guti10x/Data-Acquisition-Dashware-FUEM/Nextion - NX4827P043/README.md

# Versiones de la interfaz

## Dashboard_V1 
- Con indicadores de temperatura de los frenos del vehículo
- Con barra de progreso como indicadores de revoluciones
- Sin testigos SDC, IGN, CAN, STR, FAL y FAR
- Con loading page de carga

dash_V1

## Dashboard_V2
- Sin indicadores de temperatura de los frenos del vehículo
- Con barra de progreso como indicadores de revoluciones
- Sin testigos SDC, IGN, CAN, STR, FAL y FAR
- Con loading page de carga

dash_V2

## Dashboard_V3
- Sin indicadores de temperatura de los frenos del vehículo
- Con rectángulos de texto como indicadores de revoluciones (más óptimo)
- Sin testigos SDC, IGN, CAN, STR, FAL y FAR
- Con loading page de carga

dash_V3

## Dashboard_V4
- Sin indicadores de temperatura de los frenos del vehículo
- Con rectángulos de texto como indicadores de revoluciones (más óptimo)
- Con testigos SDC, IGN, CAN, STR, FAL y FAR versión 1
- Con loading page de carga
  
dash_V5

## Dashboard_V5
- Sin indicadores de temperatura de los frenos del vehículo
- Con rectángulos de texto como indicadores de revoluciones (más óptimo)
- Con testigos SDC, IGN, CAN, STR, FAL y FAR versión 1
- Sin loading page de carga

dash_V5

## Dashboard_V6
- Sin indicadores de temperatura de los frenos del vehículo
- Con rectángulos de texto como indicadores de revoluciones (más óptimo)
- Con testigos SDC, IGN, CAN, STR, FAL y FAR versión 2
- Sin loading pagede carga

dash_v6

<br><br>
# Pasos para cargar la Interfaz en la Pantalla Nextion

## Requisitos
- Tener instalado el Nextion Editor.

## Pasos a Seguir
1. **Abrir Nextion Editor:**
   - Iniciar/Descargar Nextion Editor.

2. **Cargar la Interfaz:**
   - Cargar la versión deseada de la interfaz en Nextion Editor.

3. **Generar Archivo TFT:**
   - Generar el archivo .TFT de la interfaz como se  uestra en la imagen:

        Captura dsse pantalla 2024-07-30 134819

5. **Guardar en Tarjeta SD:**
   - Guardar el archivo .TFT en una tarjeta SD asegurándote de que sea el único archivo en la tarjeta.

6. **Cargar la Interfaz en la Pantalla Nextion:**
   - Insertar la tarjeta SD en la pantalla Nextion.
   - Cargar la interfaz desde la tarjeta SD.

    Captura dsse swkdwkdmwkdmwd2024-07-30 134819

7. **Finalizar el Proceso:**
   - Retirar la tarjeta SD de la pantalla Nextion.
   - Reiniciar la pantalla y la  interfaz debería estar cargada y lista para usarse.
