guti10x/Data-Acquisition-Dashware-FUEM/Arduino - Arduino UNO/README.md

# Contenido de la carpeta:

#### `ScreenUpdater`: código utilizado en el código del firmware de la placa Arduino para actualizar e interactuar con la pantalla Nextion.
