guti10x/Data-Acquisition-Dashware-FUEM/Nexus - stm32f103r8t6/Librerias/nextion_comunication_lib_f1/README.md

# Librería para la comunicación entre la placa stm32 y la pantalla Nextion

Esta librería permite la comunicación entre la placa stm32 y la pantalla Nextion para la actualización de la interfaz de la pantalla del dashboard. La librería permite controlar y actualizar diversos parámetros y componentes visuales de la interfaz de manera eficiente. Las principales funcionalidades incluyen:

- **Actualización de valores en la interfaz**: La librería proporciona funciones para actualizar en tiempo real la velocidad, el voltaje de la batería, la temperatura del motor, las revoluciones, la marcha, los frenos y las barras de freno y aceleración.

- **Actualización de colores de componentes**: Permite cambiar el color de fondo de componentes individuales o de todos los componentes del dashboard para facilitar la visualización de alertas o estados específicos.

- **Cambio de interfaz**: Soporta la transición entre diferentes vistas de la pantalla, como cambiar de la vista de carga a la interfaz principal con los indicadores.

Estas funcionalidades están diseñadas para proporcionar una interfaz de usuario dinámica y reactiva, mejorando la experiencia de conducción y monitoreo en un coche de Formula Student.

## Instalación
Consulta cómo instalar e implementar la biblioteca en cualquier proyecto en STMCUBE IDE en el [manual de instalación de nextion_comunication_lib](./docs/Manual%20de%20instalación%20nextion_comunication_lib.pdf).

## Documentación
Consulta la [documentación de nextion_comunication_lib](./docs/Documentación%20nextion_comunication_lib.pdf) para obtener más información sobre cómo utilizar la librería y sus características.
