guti10x/Data-Acquisition-Dashware-FUEM/Nexus - stm32f103r8t6/Documentación de la placa/Documentación placa Nexus.pdf

# Formula UEM NEXUS

Designed by Daniel Romero de avila 2024

## Contents

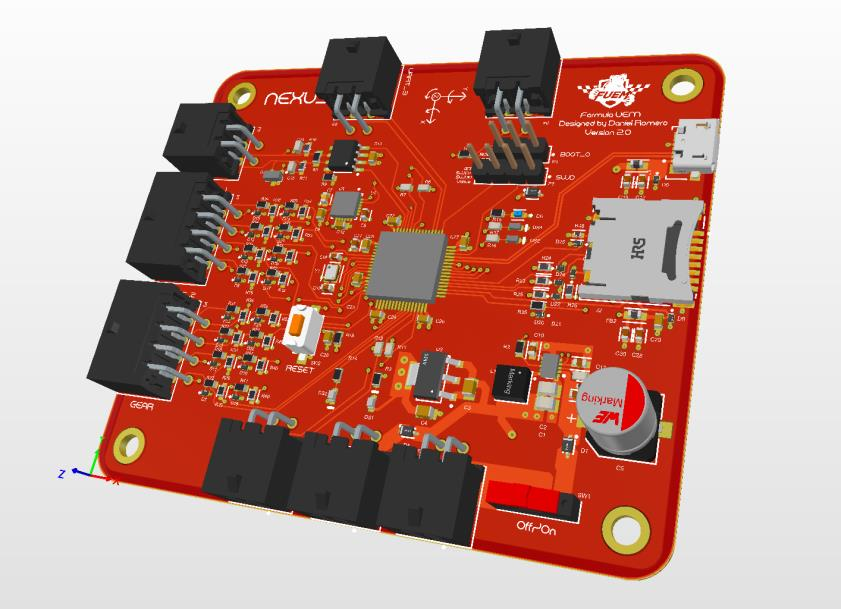
[picture p1: figure]

## 1. Overview

- 12V and 5V Power Supply
- STM32F103R8T6 Microcontroller
- Data Acquisition by SD Card
- Dashboard Power Supply
- IMU and Gyroscope 6 Axis MPU-6050
- 16 ADC 12 bit resolution
- I2C
- 2x UART
- USB

## 2. Pinout

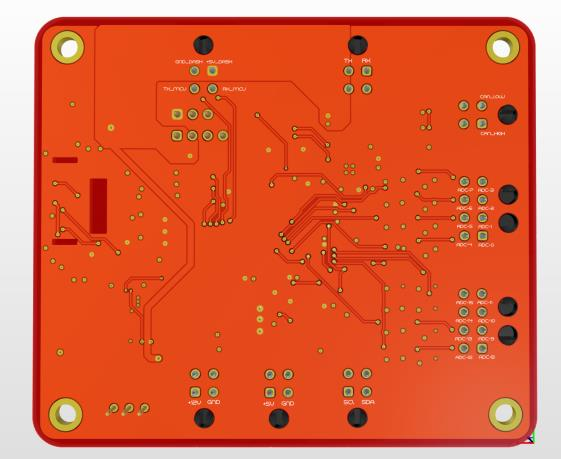
[picture p2: figure]
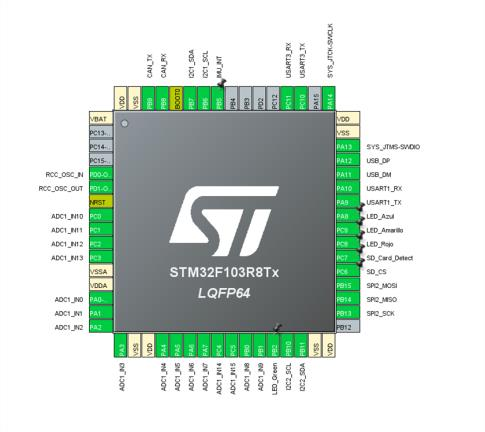
[picture p3: figure]

## 3. Technical Specification

| Unit | Value
Power voltage | V | 13.8 & 5V
Maximum current | A | 0.5
Dimensions | mm*mm | 83.27 * 71.39
Weigh | g
Temperature range | C | -20 to 50
Wire diameter Voltage range ADCs | AWG
| V | 22 to 30
| | 0 to 3.3

## 4. Assembly drawings

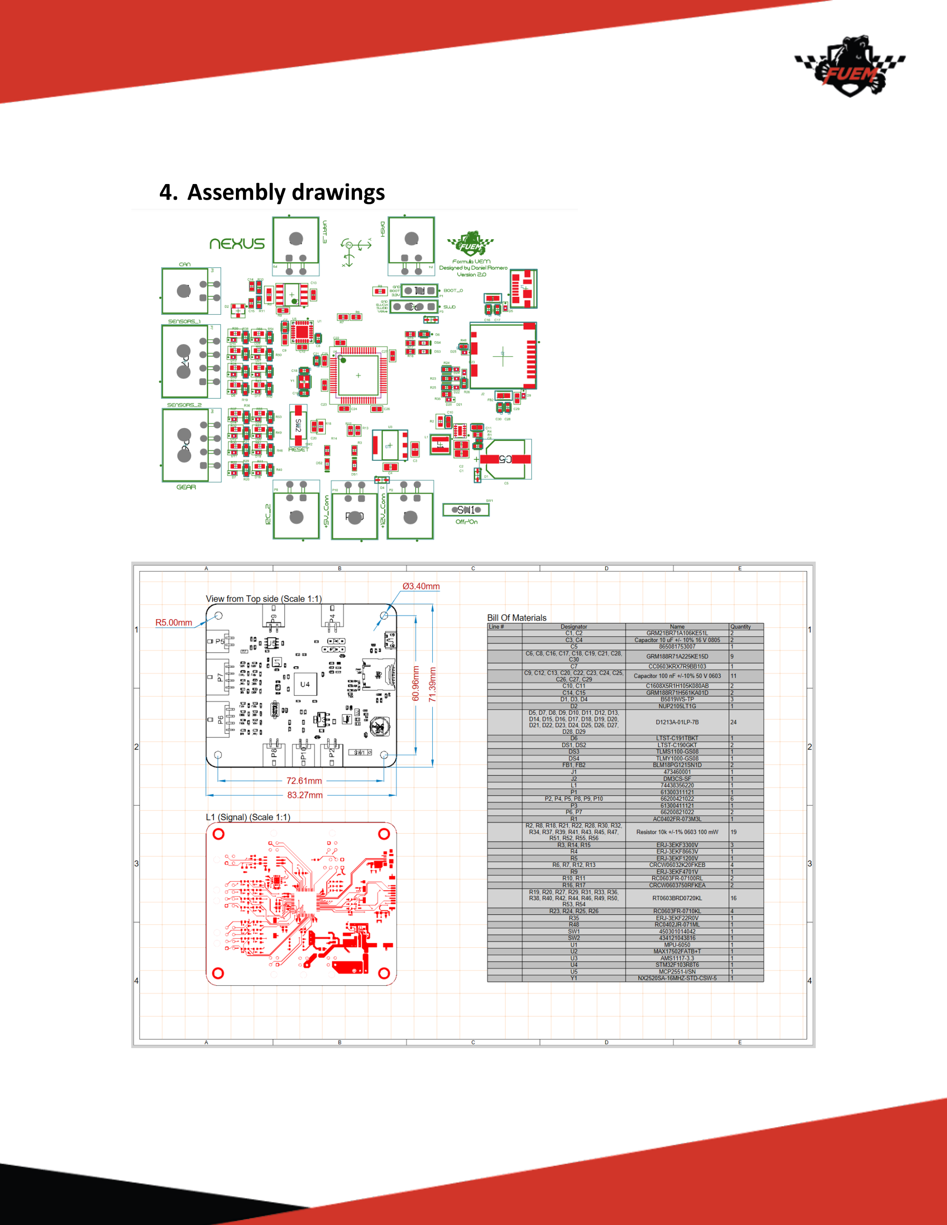
[picture p4: page 3]

## 6. Schematic

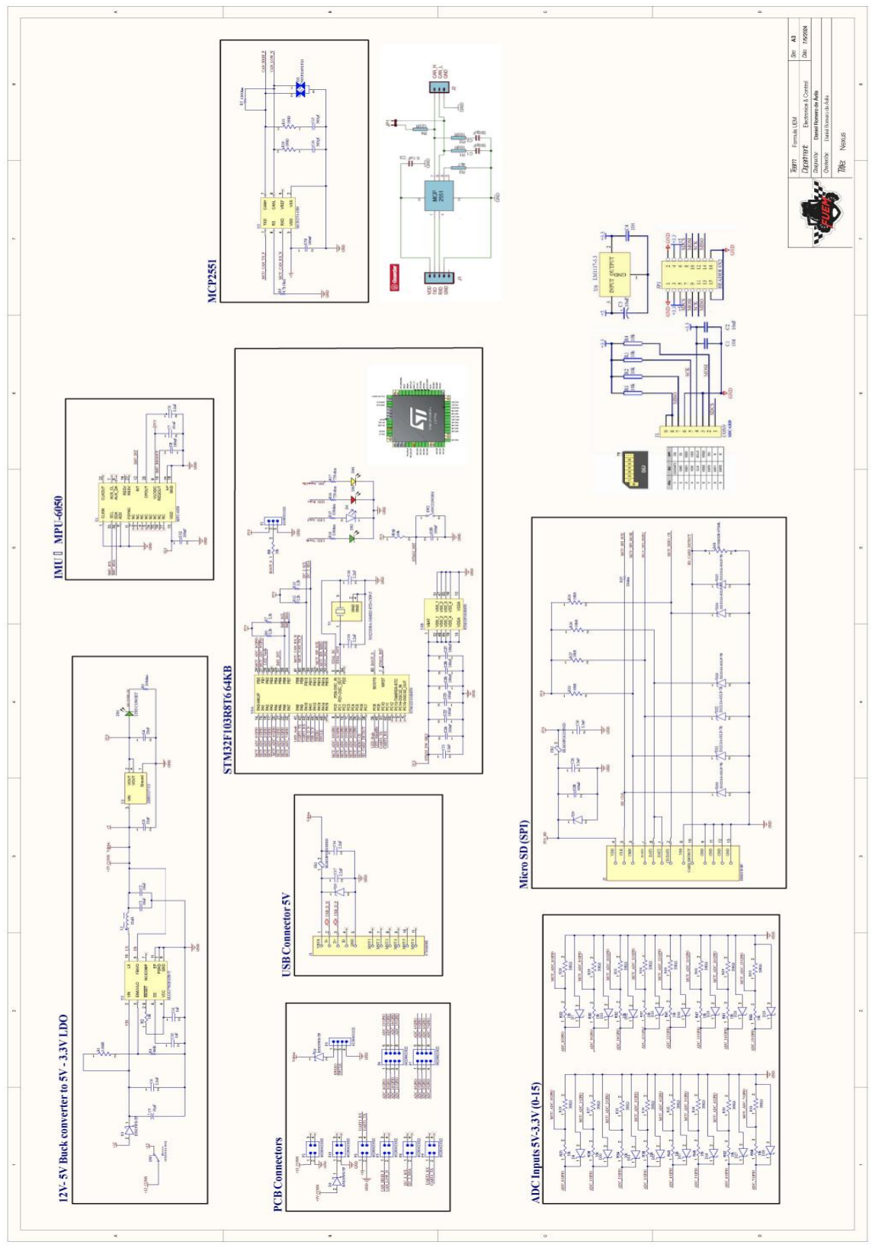
[picture p5: figure]

## 7. Bill of material

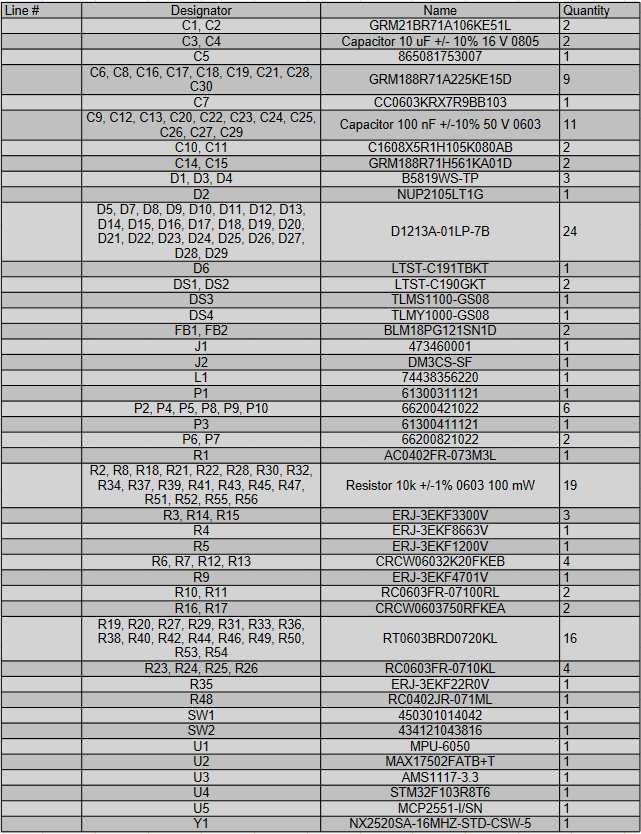
[picture p6: figure]

## 8. Conclusions

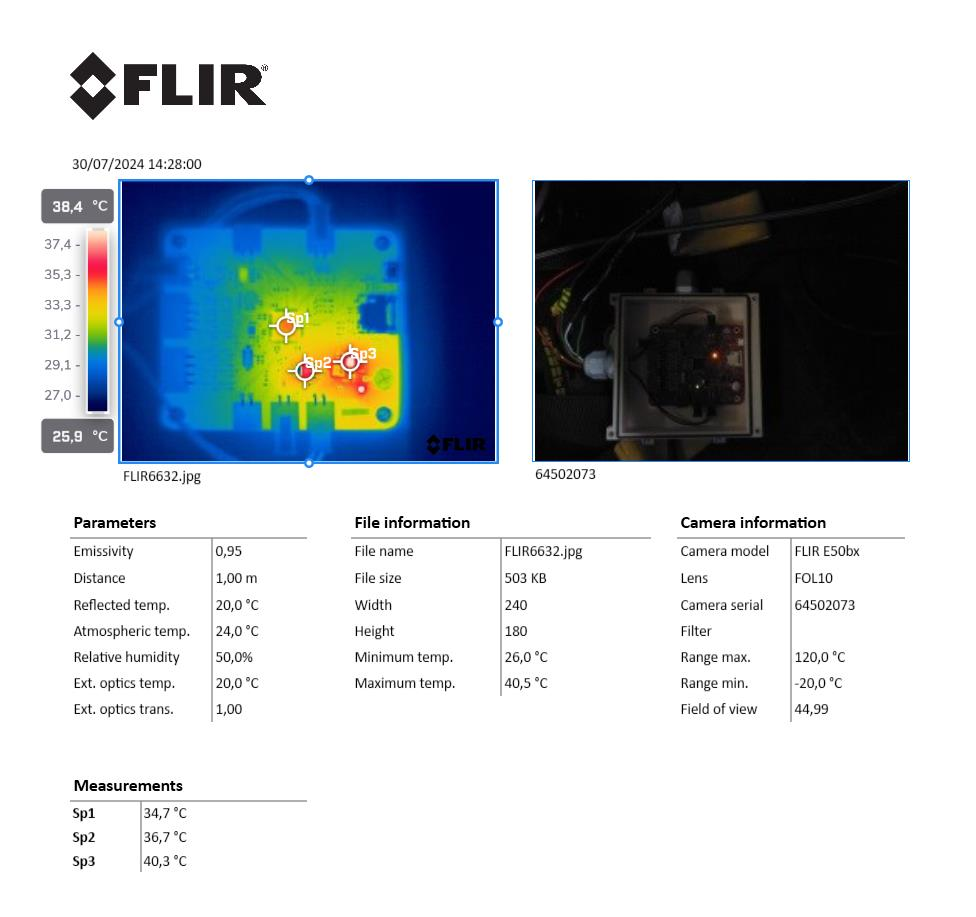
[picture p7: figure]
