guti10x/Data-Acquisition-Dashware-FUEM/Nexus - stm32f103r8t6/README.md

# Contenido de la carpeta:

#### `Documentación de la placa`: documentación de la electrónica de la placa Nexus 

#### `Librerías`: Librerías utilizadas en el código del firmware de la placa.

#### `Nexus Firmware V5`: Proyecto con el código del Firmware de la placa Nexus
