guti10x/Data-Acquisition-Dashware-FUEM/NucleoF4 - nucleo-f411re/README.md

# Contenido de la carpeta:

#### `nextion_comunication_lib_f4`: Librería utilizada en el código del firmware de la placa para actualizar e interactuar con la pantalla Nextion.

#### `dash_updater`: Proyecto con el código del Firmware de la placa NucleoF4
