guti10x/Data-Acquisition-Dashware-FUEM/Nextion - NX4827P043/assets interfaz/dash_back_3.png

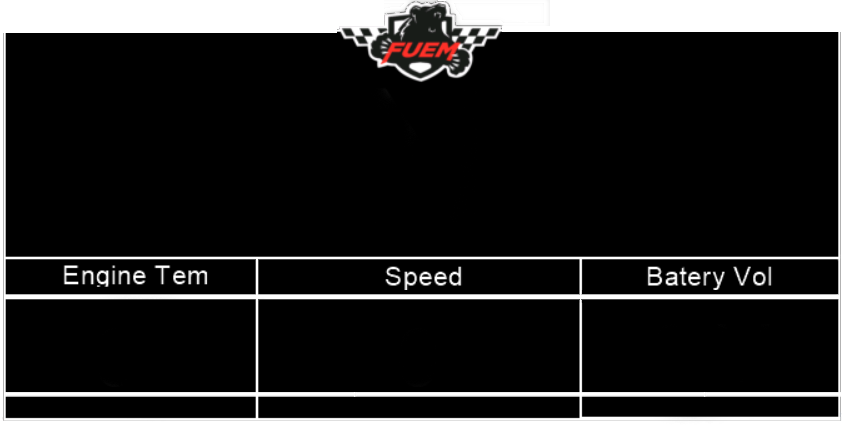
Nextion - NX4827P043/assets interfaz/dash_back_3.png
