guti10x/Data-Acquisition-Dashware-FUEM/Nexus - stm32f103r8t6/Nexus Firmware V5/Core/Src/main.c

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
/* Includes ------------------------------------------------------------------*/
#include "main.h"
#include "fatfs.h"

/* USER CODE BEGIN Includes */

#include "stdio.h"
#include "math.h"
#include "stdlib.h"
#include "stdint.h"
#include "time.h"
#include "string.h"
#include "stdbool.h"

#include "MPU_6050.h"
#include "nextion_comunication.h"
/* USER CODE END Includes */

/* USER CODE BEGIN PTD */
char Time[30];
char Date[30];
/* USER CODE END PTD */

/* USER CODE BEGIN PD */
RTC_TimeTypeDef sTime;
RTC_DateTypeDef sDate;
FATFS fs;
FIL fil;
/* USER CODE END PD */

ADC_HandleTypeDef hadc1;

CAN_HandleTypeDef hcan;

I2C_HandleTypeDef hi2c1;

RTC_HandleTypeDef hrtc;

SPI_HandleTypeDef hspi2;

UART_HandleTypeDef huart1;

void SystemClock_Config(void);
static void MX_GPIO_Init(void);
static void MX_CAN_Init(void);
static void MX_USART1_UART_Init(void);
static void MX_RTC_Init(void);
static void MX_SPI2_Init(void);
static void MX_I2C1_Init(void);
static void MX_ADC1_Init(void);
/* USER CODE BEGIN 0 */
CAN_TxHeaderTypeDef TxHeader;
CAN_RxHeaderTypeDef RxHeader;

uint32_t TxMailbox; 	//Un MAILBOX es una paquete con espacio para 4 Bytes donde se preparan los datos a enviar
						//Supports 3 different Mailboxes (Search it in the datasheet form MCU)
uint8_t TxData[8];
uint8_t RxData[8];

int Engine_Speed = 0;
uint8_t Throttle_Pos = 0;
uint8_t Coolant_Temp = 0;
uint8_t Battery_Voltage = 0;
float Battery_Voltage_Float = 0;
uint8_t Throttle_Pedal = 0;
int16_t Brake_Pressure = 0;
int16_t RPM = 0;
uint8_t Ignition = 0;
uint8_t SDC = 0;
uint8_t Sw_Starter = 0;
uint8_t Left_Fan = 0;
uint8_t Right_Fan = 0;
uint16_t Gear = 0;
uint8_t Brake_Percentage = 0;

uint8_t CAN_Status = 0;

//float Acc_X = 0;
//float Acc_Y = 0;
//float Acc_Z = 0;

uint8_t MPU_6050_Temp = 0;

// Textos para mostrar datos (se necesitan las siguintes varibles en formato texto para poder mostrarslas en la interfaz)
char RPM_text[20];  // Texto con valor de RPM
char Speed_Text[20];  // Texto con valor velocidad
char Coolant_Text[20];  // Texto con valor de temperatura del refrigerante
char Battery_Text[20];  // Texto con valor de voltaje de la batería
char Ambient_Temperature_Text[20];
char Gear_Text[5] = "N";


const char *array_elementos[] = {"speed", "revValue", "gear", "brake1", "brake2", "brake3", "brake4"};


void HAL_CAN_RxFifo0MsgPendingCallback(CAN_HandleTypeDef *hcan)
{

	HAL_CAN_GetRxMessage(hcan, CAN_RX_FIFO0, &RxHeader, RxData);
	HAL_GPIO_WritePin(GPIOC, GPIO_PIN_8, GPIO_PIN_RESET);
	HAL_GPIO_TogglePin(GPIOA, GPIO_PIN_8);
	switch (RxHeader.StdId){

//	case 0x118:
////			Engine_Speed = (uint8_t)RxData[0];
//
////			Throttle_Pos = (uint8_t)RxData[1];
//
////			Coolant_Temp = (uint8_t)RxData[3];
//			break;

		case 0x120:
			CAN_Status = 1;

			//Revisar esta parte de las variables de Engine Speed
			Engine_Speed = (uint8_t)RxData[0];
			Engine_Speed = (int)Engine_Speed *100;
			Throttle_Pos = (uint8_t)RxData[1];
			Coolant_Temp = (uint8_t)RxData[2];
			Battery_Voltage = (uint8_t)RxData[3];
			Battery_Voltage_Float = (float)Battery_Voltage/10;
			Brake_Pressure = (int16_t)RxData[4]<<8 | RxData[5];
			Brake_Percentage = 0.0138*Brake_Pressure;
			NEXTION_SendNumber(&huart1, "brakePedal", Brake_Percentage);

			MPU_6050_Temp = MPU_6050_Get_Temp();
			HAL_ADC_Start(&hadc1);
			HAL_ADC_PollForConversion(&hadc1, HAL_MAX_DELAY);
			Gear = HAL_ADC_GetValue(&hadc1);

			//Condicionales para conocer el valor de la Marcha
			if ((Gear>=40)&&(Gear<500)){
				strcpy(Gear_Text,"N");
				NEXTION_SendText(&huart1, "gear", Gear_Text, NULL);
			}
			else if((Gear>=600)&&(Gear<950)){
				strcpy(Gear_Text,"1");
				NEXTION_SendText(&huart1, "gear", Gear_Text, NULL);
			}
			else if((Gear>=1000)&&(Gear<1350)){
				strcpy(Gear_Text,"2");
				NEXTION_SendText(&huart1, "gear", Gear_Text, NULL);
			}
			else if((Gear>=1500)&&(Gear<1800)){
				strcpy(Gear_Text,"3");
				NEXTION_SendText(&huart1, "gear", Gear_Text, NULL);
			}
			else if((Gear>=1900)&&(Gear<2100)){
				strcpy(Gear_Text,"4");
				NEXTION_SendText(&huart1, "gear", Gear_Text, NULL);
			}
			else if((Gear>=2150)&&(Gear<2400)){
				strcpy(Gear_Text,"5");
				NEXTION_SendText(&huart1, "gear", Gear_Text, NULL);
			}
			else if(Gear>=2400){
				strcpy(Gear_Text,"6");
				NEXTION_SendText(&huart1, "gear", Gear_Text, NULL);
			}


			//Funcion para enviar las revoluciones del motor
			sprintf(RPM_text, "%d", Engine_Speed);
			NEXTION_SendText(&huart1, "revValue", RPM_text, NULL);
			NEXTION_Send_Revs_v2(&huart1, Engine_Speed);

			//Funcion para enviar la posicion de la mariposa
			NEXTION_SendNumber(&huart1, "acePedal", Throttle_Pos);

			//Funcion para enviar la temperatura del refrigerante
			sprintf(Coolant_Text, "%d", Coolant_Temp);
			NEXTION_SendText(&huart1,"engineTemp",Coolant_Text,"\xB0");

			sprintf(Ambient_Temperature_Text, "%d", MPU_6050_Temp);
			NEXTION_SendText(&huart1,"ambtemperature",Ambient_Temperature_Text,"\xB0");

			//Condicional para el estado del CAN
			if (CAN_Status == 1){
				NEXTION_estado_color(&huart1, "can", 1024);
			}
			else{
				NEXTION_estado_color(&huart1, "can", 63488);
			}



			//Creamos el condicional para los colores de la temperatura de refrigerante

			if (Coolant_Temp<95){
				NEXTION_estado_color(&huart1, "engineTemp", 36609);
			}
			else if((Coolant_Temp>=95)&&(Coolant_Temp<=99)){
				NEXTION_estado_color(&huart1, "engineTemp", 64520);
			}
			else{
				NEXTION_estado_color(&huart1, "engineTemp", 63488);
			}


			sprintf(Battery_Text, "%.1f",Battery_Voltage_Float);
			NEXTION_SendText(&huart1,"voltage",Battery_Text,"V");

			//Creamos el condicional para los colores de la bateria
			if (Battery_Voltage>=12.5){
				NEXTION_estado_color(&huart1, "voltage", 36609);
			}
			else if((Battery_Voltage<12.5)&&(Battery_Voltage>=12)){
				NEXTION_estado_color(&huart1, "voltage", 64520);
			}
			else{
				NEXTION_estado_color(&huart1, "voltage", 63488);
			}

			NEXTION_SendNumber(&huart1, "brakePedal", Brake_Pressure);
			break;

		//case 0x64D:

			//break;

		case 0x521:
			Ignition = (uint8_t)RxData[0];
			SDC = (uint8_t)RxData[1];
			Sw_Starter = (uint8_t)RxData[2];
			Left_Fan = (uint8_t)RxData[3];
			Right_Fan = (uint8_t)RxData[4];

			//Condicional para el estado del Ignition
						if (Ignition == 1){
							NEXTION_estado_color(&huart1, "ignition", 1024);
						}
						else {
							NEXTION_estado_color(&huart1, "ignition", 63488);
						}

						//Condicional para el estado SDC
						if (SDC == 0){
							NEXTION_estado_color(&huart1, "sdc", 1024);
						}
						else{
							NEXTION_estado_color(&huart1, "sdc", 63488 );
						}

						//Condicional para el estado del Starter
						if (Sw_Starter == 1){
							NEXTION_estado_color(&huart1, "str", 1024);
						}
						else {
							NEXTION_estado_color(&huart1, "str", 63488);
						}
						//Condicional para el estado del Left Fan
						if (Left_Fan == 1){
							NEXTION_estado_color(&huart1, "fanLeft", 1024);
						}
						else {
							NEXTION_estado_color(&huart1, "fanLeft", 63488);
						}
						//Condicional para el estado del Right Fan
						if (Right_Fan == 1){
							NEXTION_estado_color(&huart1, "fanRight", 1024);
						}
						else {
							NEXTION_estado_color(&huart1, "fanRight", 63488);
						}

			break;
//		case 0x655:
//			//Brake_Pressure = (int16_t)RxData[0]<<8 | RxData[1];
//
//
//			break;


	}

//	if (RxHeader.StdId == 0x118){
//	Message_Ready118 = 1;
//	}
}
/* USER CODE END 0 */

/**
  * @brief  The application entry point.
  * @retval int
  */
int main(void)
{

  /* MCU Configuration--------------------------------------------------------*/

  /* Reset of all peripherals, Initializes the Flash interface and the Systick. */
  HAL_Init();

  /* Configure the system clock */
  SystemClock_Config();

  /* Initialize all configured peripherals */
  MX_GPIO_Init();
  MX_CAN_Init();
  MX_USART1_UART_Init();
  MX_RTC_Init();
  MX_SPI2_Init();
  MX_FATFS_Init();
  MX_I2C1_Init();
  MX_ADC1_Init();
  /* USER CODE BEGIN 2 */


  //NEXTION_SendPageChange(&huart1,"page2");
  //HAL_Delay(2800);

             //Mostrar dashware page
 // NEXTION_SendPageChange(&huart1,"page1");

             //Inicializar interfaz a negro (por si se quedó la página con estilos a rojo por alguna alerta provocada por NEXTION_Alert())
  //NEXTION_Alert(&huart1, 0);

  HAL_CAN_Start(&hcan);

  HAL_CAN_ActivateNotification(&hcan, CAN_IT_RX_FIFO0_MSG_PENDING);

  MPU_6050_init();

  HAL_GPIO_WritePin(GPIOC, GPIO_PIN_8, GPIO_PIN_SET);
  /* USER CODE END 2 */

  /* Infinite loop */
  /* USER CODE BEGIN WHILE */
  while (1)
  {
    /* USER CODE END WHILE */

    /* USER CODE BEGIN 3 */

	//HAL_RTC_GetDate(&hrtc, &sDate, RTC_FORMAT_BIN);
	//HAL_RTC_GetTime(&hrtc, &sTime, RTC_FORMAT_BIN);

	//sprintf(Date,"Date: %02d.%02d.%02d\t",sDate.Date,sDate.Month,sDate.Year);
	//sprintf(Time,"Time: %02d.%02d.%02d\t",sTime.Hours,sTime.Minutes,sTime.Seconds);

  }
  /* USER CODE END 3 */
}

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
