guti10x/Data-Acquisition-Dashware-FUEM/Nexus - stm32f103r8t6/Nexus Firmware V5/Nexus.ioc

Mcu.UserName=STM32F103R8Tx
PA0-WKUP.Signal=ADCx_IN0
PA10.Signal=USART1_RX
PA13.Signal=SYS_JTMS-SWDIO
PA14.Signal=SYS_JTCK-SWCLK
PA8.Signal=GPIO_Output
PA9.Signal=USART1_TX
PB13.Signal=SPI2_SCK
PB14.Signal=SPI2_MISO
PB15.Signal=SPI2_MOSI
PB2.Signal=GPIO_Output
PB6.Signal=I2C1_SCL
PB7.Signal=I2C1_SDA
PB8.Signal=CAN_RX
PB9.Signal=CAN_TX
PC6.GPIO_Label=SD_CS
PC6.Signal=GPIO_Output
PC8.Signal=GPIO_Output
PC9.GPIO_Label=LED_Amarillo 
PC9.Signal=GPIO_Output
