guti10x/Data-Acquisition-Dashware-FUEM/NucleoF4 - nucleo-f411re/dash_updater/Core/Src/main.c

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
/* Includes ------------------------------------------------------------------*/
#include "main.h"
#include "math.h"
#include "stdio.h"
#include "stdlib.h"
#include <stdint.h>
#include <time.h>
#include "nextion_comunication.h"

UART_HandleTypeDef huart1;
UART_HandleTypeDef huart2;

void SystemClock_Config(void);
static void MX_GPIO_Init(void);
static void MX_USART2_UART_Init(void);
static void MX_USART1_UART_Init(void);
/* USER CODE BEGIN 0 */
void procesarReceivedCan(uint16_t valor) {
    // Generar un número aleatorio entre 0 y 9
    int random_value = rand() % 100;
    int rev = rand() % 9000;

    char text[4]; // Suponiendo que los valores aleatorios solo van de 0 a 9
    sprintf(text, "%d", random_value);

    // Añadir un retraso de 10ms
    HAL_Delay(10);

    switch(valor) {
        case 0x110:
        	NEXTION_SendText(&huart1,"speed", text, NULL);

            break;
        case 0x120:
        	NEXTION_SendText(&huart1,"voltage", text, "V");
        	if (random_value > 0 && random_value <= 50) {
        	    NEXTION_Alert(&huart1, 0); //black
        	    NEXTION_estado_color(&huart1, "voltage", 36609);  //green-
        	} else if (random_value > 50 && random_value <= 80) {
        	    NEXTION_Alert(&huart1, 0); //black
        	    NEXTION_estado_color(&huart1, "voltage", 64520); //orange
        	} else if (random_value > 91) {
        	    NEXTION_Alert(&huart1, 63488); // red
        	    NEXTION_estado_color(&huart1, "voltage", 63488); //red
        	}

            break;

        case 0x655:
        	NEXTION_SendNumber(&huart1, "brakePedal", random_value);
            break;
        case 0x640:
        	strcpy(text, "2");
        	NEXTION_SendText(&huart1,"revValue", "car", " RPM");
            break;
        case 0x641:
        	NEXTION_SendText(&huart1,"gear", text, NULL);
            break;
        case 0x642:
        	NEXTION_SendNumber(&huart1, "acePedal", random_value);
            break;
        case 0x643:
        	NEXTION_SendText(&huart1,"brake1", text, "\xB0");
            break;
        case 0x644:
        	NEXTION_SendText(&huart1,"brake2", text, "\xB0");
            break;
        case 0x645:
        	NEXTION_SendText(&huart1,"brake3", text, "\xB0");
            break;
        case 0x646:
        	NEXTION_SendText(&huart1,"brake4", text, "\xB0");
            break;
        case 0x647:
        	NEXTION_SendText(&huart1,"engineTemp", text, "\xB0");
        	if (random_value > 0 && random_value <= 50) {
        	    NEXTION_Alert(&huart1,0); //black
        	    NEXTION_estado_color(&huart1, "engineTemp", 36609);  //green
        	} else if (random_value > 50 && random_value <= 80) {
        	    NEXTION_Alert(&huart1,0);
        	    NEXTION_estado_color(&huart1, "engineTemp", 64520); //orange
        	} else if (random_value > 91) {
        	    NEXTION_Alert(&huart1,63488); // red
        	    NEXTION_estado_color(&huart1, "engineTemp", 63488); // red
        	}

			break;

        case 0x648:
        	NEXTION_Send_Revs_v2(&huart1, rev);
            break;
        default:
            break;
    }
}
/* USER CODE END 0 */

/**
  * @brief  The application entry point.
  * @retval int
  */
int main(void)
{

  /* MCU Configuration--------------------------------------------------------*/

  /* Reset of all peripherals, Initializes the Flash interface and the Systick. */
  HAL_Init();

  /* USER CODE BEGIN Init */
    // Semilla para la generación de números aleatorios
    srand(time(NULL));
  /* USER CODE END Init */

  /* Configure the system clock */
  SystemClock_Config();

  /* Initialize all configured peripherals */
  MX_GPIO_Init();
  MX_USART2_UART_Init();
  MX_USART1_UART_Init();
  /* USER CODE BEGIN 2 */
  //Mostrar landing view
  //NEXTION_SendPageChange(&huart1,"page0");
  //HAL_Delay(2800);
  //Mostrar dash view
  //NEXTION_SendPageChange(&huart1,"page2");
  HAL_Delay(3400);
  //Mostrar dash view
  //NEXTION_SendPageChange(&huart1,"page3");
  //HAL_Delay(2800);
  //Mostrar dash view
  NEXTION_SendPageChange(&huart1,"page1");

  //Inicializar interfaz a negro (por si se quedó con estilos a rojo por NEXTION_Alert())
  NEXTION_Alert(&huart1, 0);
  /* USER CODE END 2 */

  /* Infinite loop */
  /* USER CODE BEGIN WHILE */
  while (1)
  {
	  	//HAL_Delay(400);
	  	int randoom_value = 2;
	  	char text[20]; // Declarar variable donde alamcenar la conversión
	  	sprintf(text, "%d", randoom_value); //Inicializar la conversión

	  	// Generar valor aleatorio entre 0 y 9
	  	int random_value = rand() % 12;

	  	switch(random_value) {
	  		case 0:
	  			procesarReceivedCan(0x110);
	  			break;
	  		case 1:
	  			procesarReceivedCan(0x120);
	  			break;
	  		case 2:
	  			procesarReceivedCan(0x655);
	  			break;
	  		case 3:
	  			procesarReceivedCan(0x640);
	  			break;
	  		case 4:
	  			procesarReceivedCan(0x641);
	  			break;
	  		case 5:
	  			procesarReceivedCan(0x642);
	  			break;
	  		case 6:
	  			procesarReceivedCan(0x643);
	  			break;
	  		case 7:
	  			procesarReceivedCan(0x644);
	  			break;
	  		case 8:
	  			procesarReceivedCan(0x645);
	  			break;
	  		case 9:
	  			procesarReceivedCan(0x646);
	  			break;
	  		case 10:
	  			procesarReceivedCan(0x647);
	  			break;
	  		case 11:
	  			procesarReceivedCan(0x648);
	  			break;
	  		default:
	  			printf("Número aleatorio fuera de rango\n");
	  			break;
	  	}

	}

}

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
