guti10x/Data-Acquisition-Dashware-FUEM/Nexus - stm32f103r8t6/Nexus Firmware V5/Core/Inc/main.h

#define SD_CS_Pin GPIO_PIN_6
#define SD_CS_GPIO_Port GPIOC
#define LED_Amarillo_Pin GPIO_PIN_9
#define LED_Amarillo_GPIO_Port GPIOC
