guti10x/Data-Acquisition-Dashware-FUEM/(commit log)

2024-02-15 Add comunicación Arduino con elementos tipo text y bar de la interfaz de la pantalla
2024-02-20 Add breaks con estado de colores
2024-02-21 Add cambio pantalla a rojo si voltaje bateria o temperaruta motor es elevada
2024-02-21 fix lógica num de inidcadores de revoluciones
    [ScreenUpdater.ino]
2024-02-26 Interfaz version 2 con barra de progreso para indicadores de revoluciones
2024-02-27 Add lógica barra progreso de indicadores de revoluines
2024-05-01 Add controlador de la interfaz para la placa stm32 + función actualizar atributo .txt de los elementos tipo texto de la interfaz
2024-05-01 Add función procesarReceivedCan() para procesar mensaje recibido de la comunicacón Can y actualizar valor en la pantalla
2024-05-02 creada funcionalidad de revoluciones y solucionados problemas del código de dani
    [main.c]
2024-05-02 Este commit es de dani. Video del inicio anadido
2024-05-03 Add loading view al iniciar el controller de la interfaz
2024-05-03 Añadidas unidades de los grados y ajustada la pantalla para que no se repita
2024-05-03 optimizar fucniones mandar text a la interfaz en uan genérica + Add método alert (si el "voltage" o "engineTemp" es superio a X valor actualiza todos los colores de los componentes de la interfaz a r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
2024-05-03 Add cambio de color (green,orange, red) del voltaje bateria y temperatura del metor en función de su valor
2024-05-07 Implemtación de biblioteca
2024-06-10 Cambio de colores de las barras de revolcuinoes + Add uniformidad a las lineas limitadoras de la interfaz
2024-06-10 Add manual de instalación y documentacion de la libreria nextion_comunication_lib
2024-06-10 Add explicación del UART a la documentacion de la libreria nextion_comunication_lib
2024-06-12 fix importación de biblioteca en proyecto de prueba
2024-06-12 Add versiones alternativas de loading page
2024-06-13 minor issues resolved (change tonalidad azul pedal de acelereación + fix todas las celdas se cambian a rojo en función alert)
    [main.c]
2024-06-18 Create proyect para la placa stm32f103r8t6 (Nexus)
2024-06-19 Add MPU_6050 lib + initialize CAN, I2C1 and USART3
2024-06-19 Add Can receiver code + lectura sensor MPU-6050 y temperatura
2024-06-24 Add cambio de vista en la interfaz: landing page -> dashware view
2024-06-29 Add versión de la interfaz con frenos
2024-06-29 fix importación de librerias
2024-06-29 Add README: versiones de la interfaz.md
2024-07-09 Add interfaz V3 optimizada con rectangulos para los indicadores de RPMS
2024-07-13 Add NEXTION_Send_Revs_v2() para actualizar el color de los rectangulos de colores de los indicadores de revoluciones + change baudrate de 9600 -> 115200
2024-07-13 Update all nextion_comunication_libs con NEXTION_Send_Revs_v2() (para actualizar el color de los rectangulos de colores de los indicadores de revoluciones)
2024-07-14 Update Manual de instalación nextion_comunication_lib
2024-07-19 fix rutas documentación y manual de instalación de nextion_comunication_lib
2024-07-31 Add testigo funcionamiento fan right, fan left and STR
2024-07-31 Add testigos sdc, can, ignition, str, fanLeft, fanRight, ambtemp + Add función para detectar errores del CAN + Add funciones change colores
    [Nexus.ioc, main.c, main.h, nextion_comunication.c, nextion_comunication.h]
2024-07-31 Update nuevos testigos en la interfaz en el README.md
2024-07-31 Add documentación de la electrónica de la placa Nexus
2024-07-31 Add Readmes con expliación del contenido de cada carpeta del repo
2024-08-01 Update documentación con testigos de la interfaz + mejorar alineación del documento
2024-08-01 fix rutas de los enlaces del README.md
