guti10x/Data-Acquisition-Dashware-FUEM/(notices)

Notices in the files:
NucleoF4 - nucleo-f411re/dash_updater/Core/Src/main.c:
Copyright (c) 2024 STMicroelectronics.
All rights reserved.
This software is licensed under terms that can be found in the LICENSE file
